felisan99/Breeze-UY/img/poster_breeze.jpg

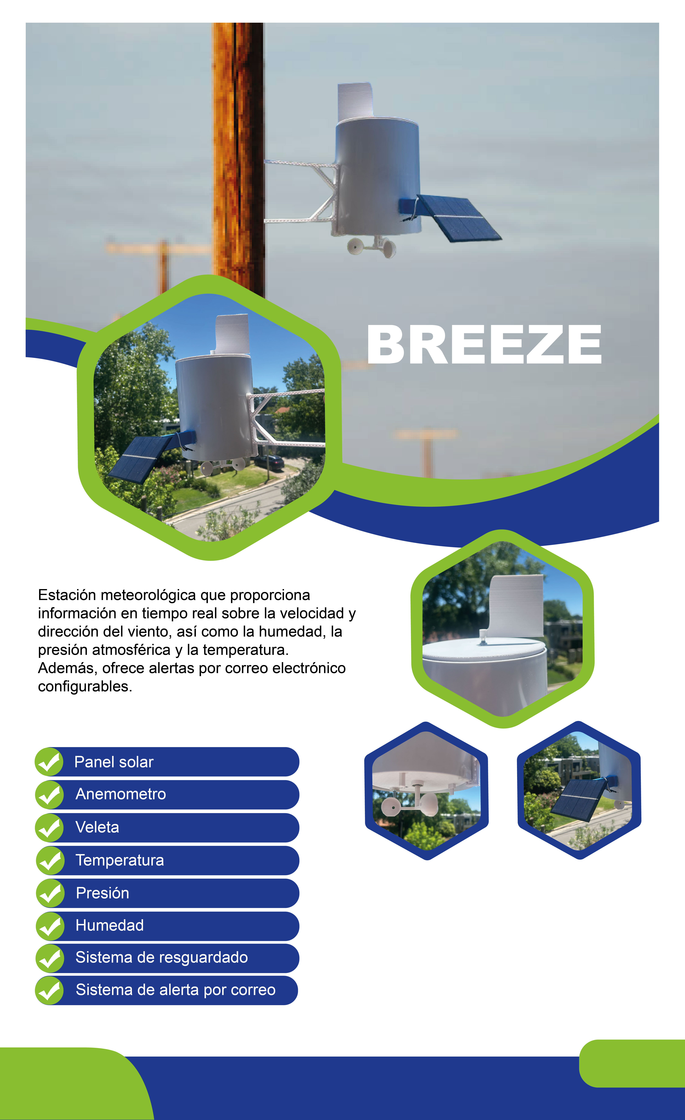
img/poster_breeze.jpg
