felisan99/Breeze-UY/img/joaco.png

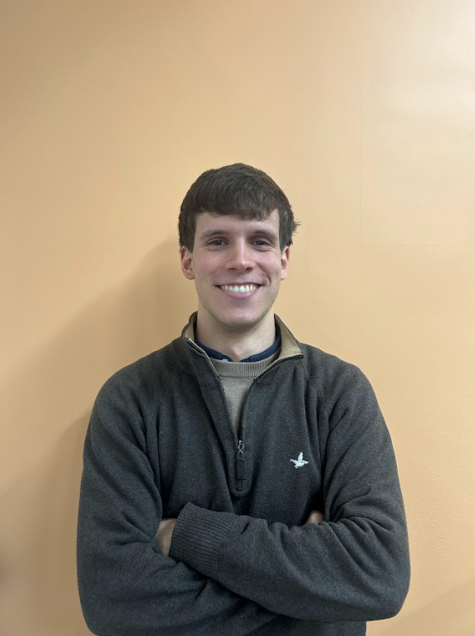
img/joaco.png
