felisan99/Breeze-UY/img/cargador.jpeg

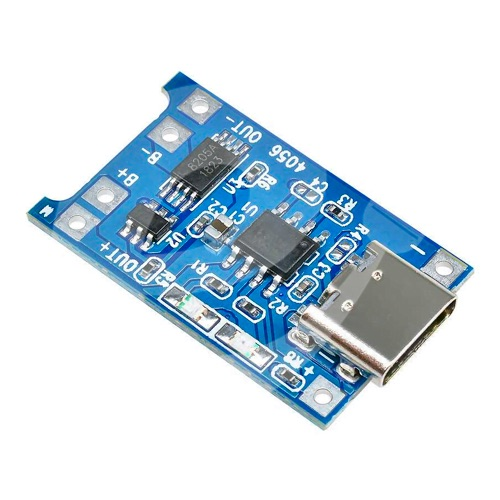
img/cargador.jpeg
