felisan99/Breeze-UY/img/Diagrama modulos.png

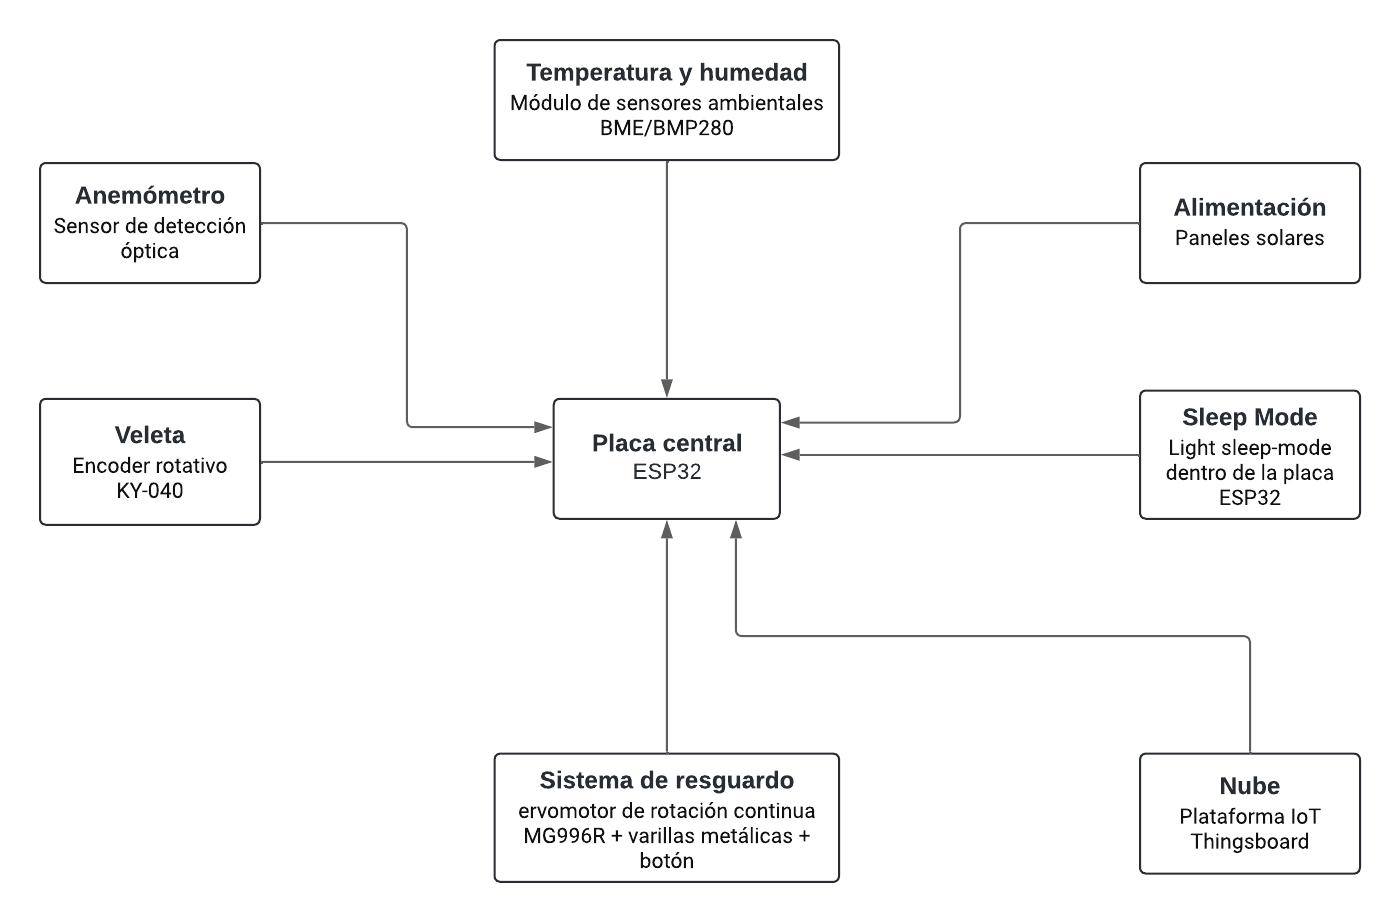
img/Diagrama modulos.png
