felisan99/Breeze-UY/img/elias.png

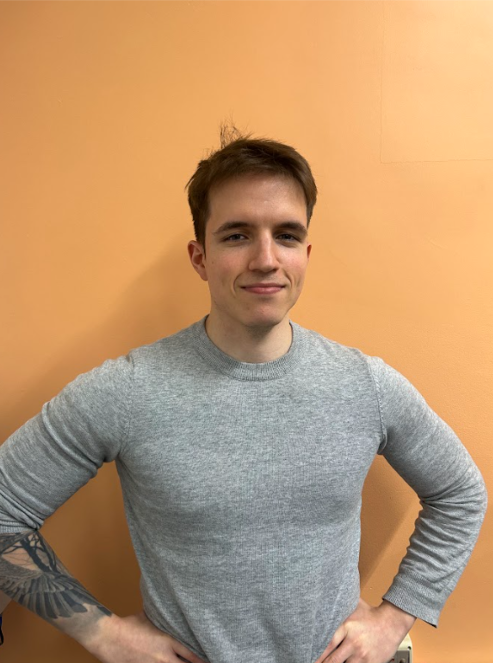
img/elias.png
