felisan99/Breeze-UY/img/elsid.png

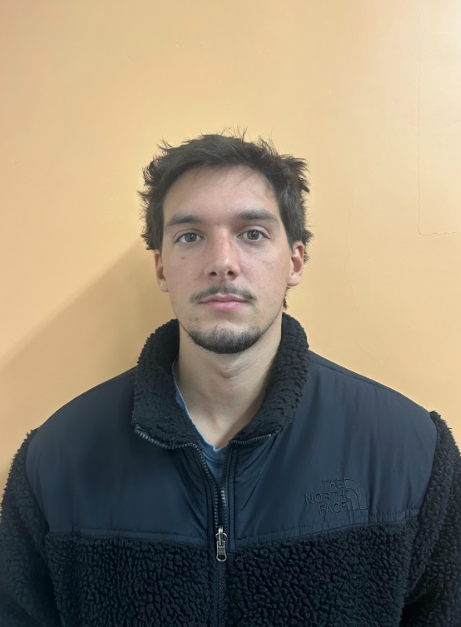
img/elsid.png
