felisan99/Breeze-UY/img/encoder.jpeg

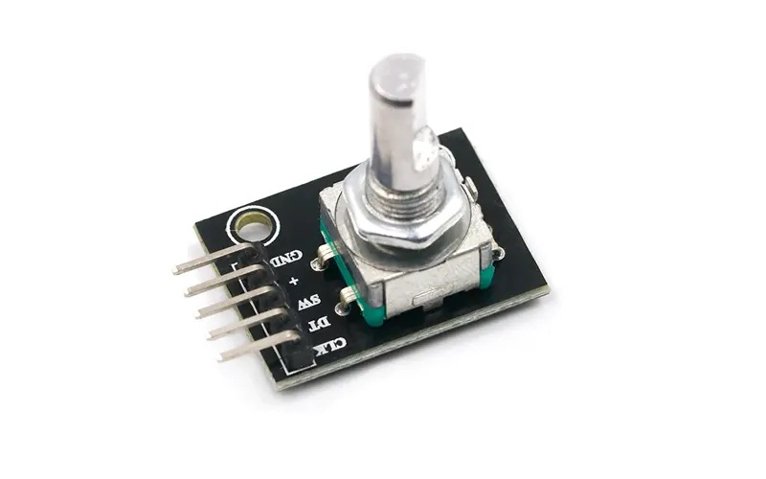
img/encoder.jpeg
