felisan99/Breeze-UY/img/flujo_loop.png

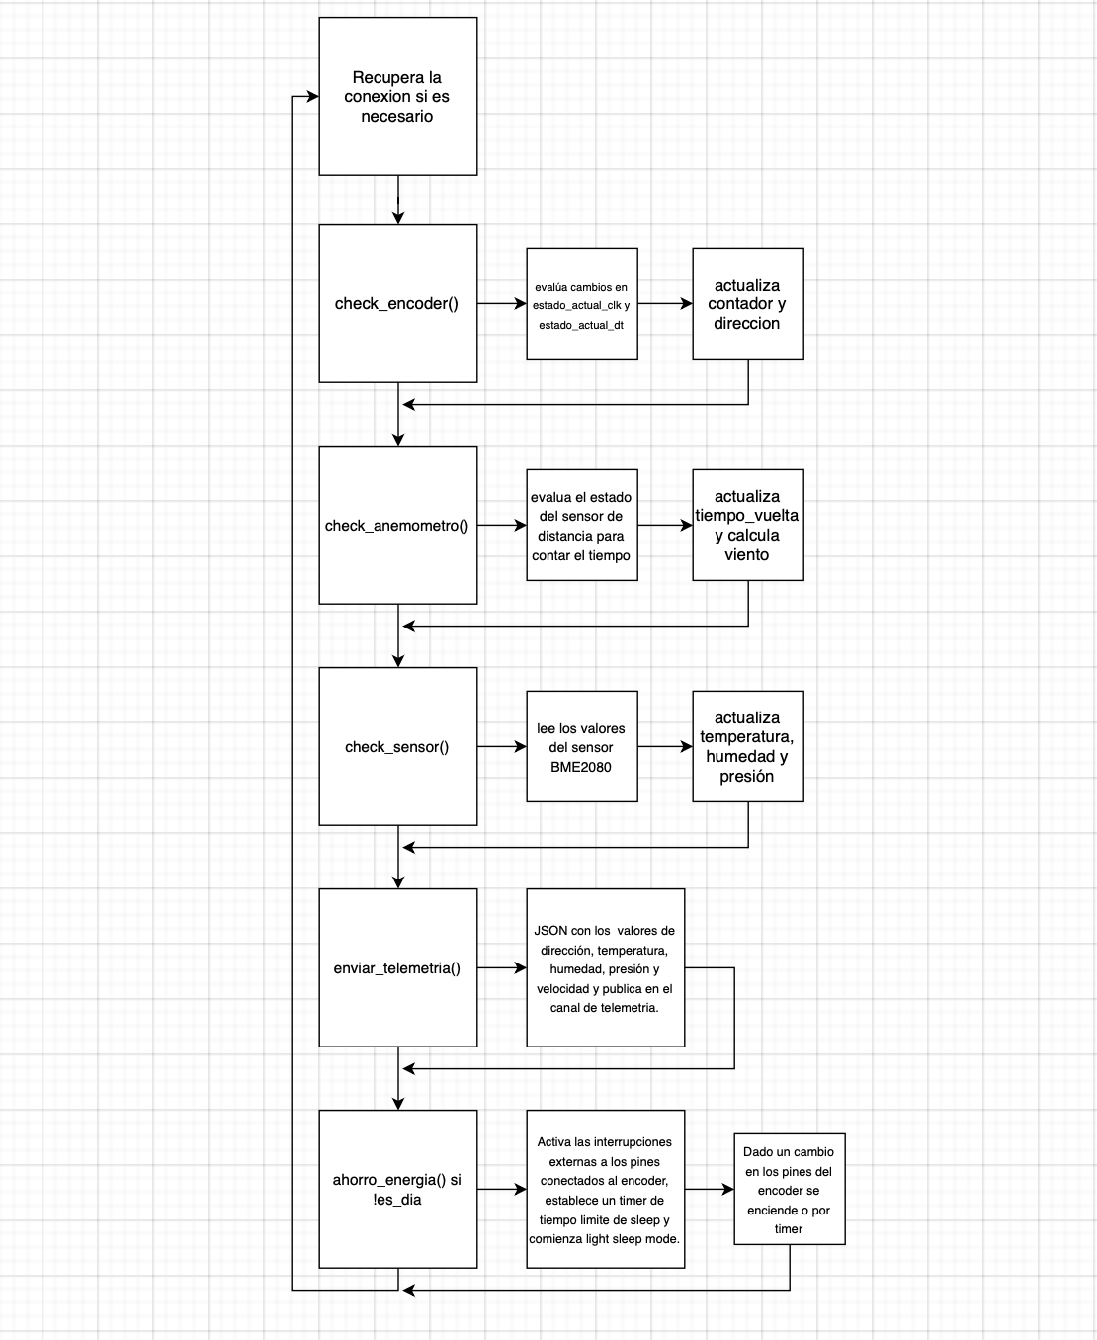
img/flujo_loop.png
