felisan99/Breeze-UY/img/foto breeze 1.jpeg

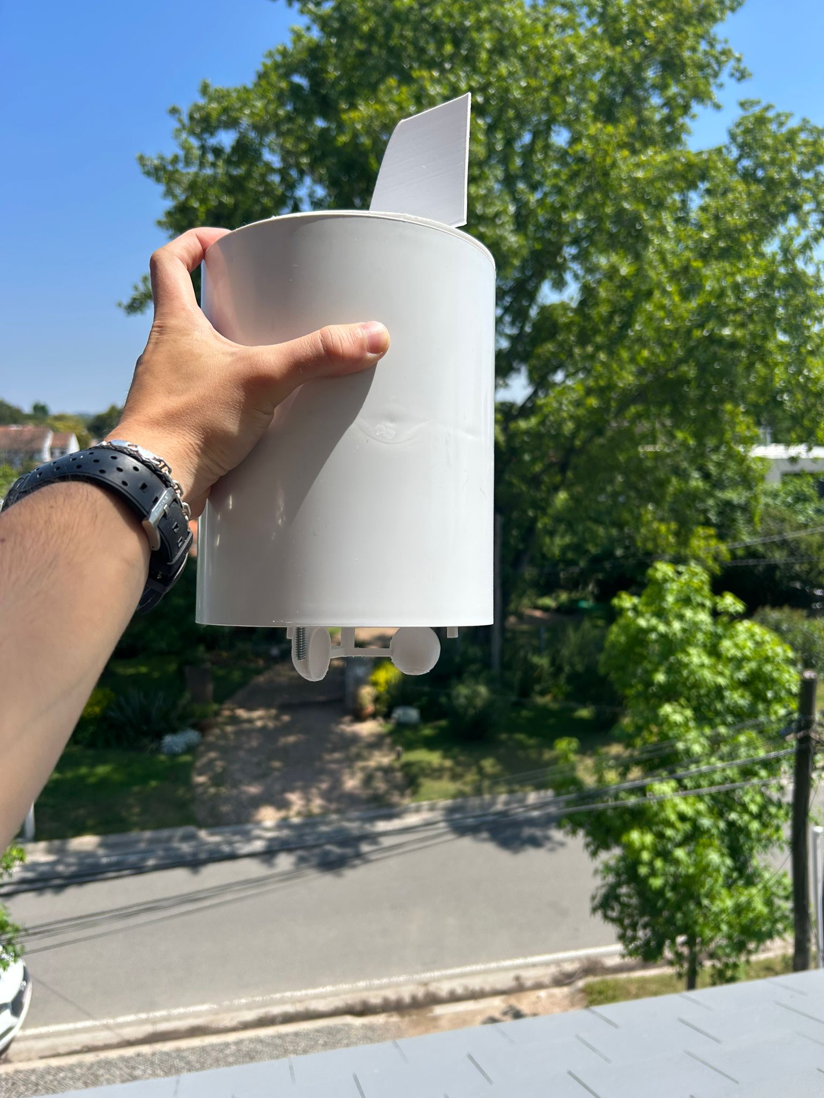
img/foto breeze 1.jpeg
