felisan99/Breeze-UY/img/foto breeze 2.jpeg

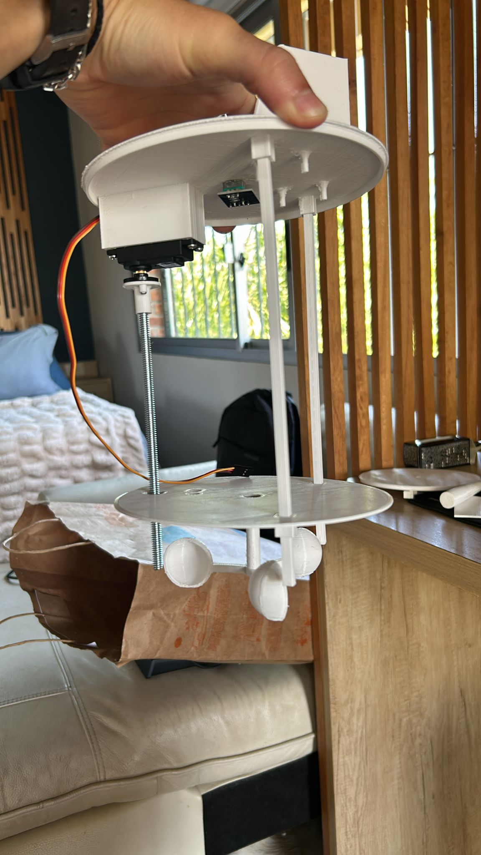
img/foto breeze 2.jpeg
