felisan99/Breeze-UY/img/foto breeze 3.jpeg

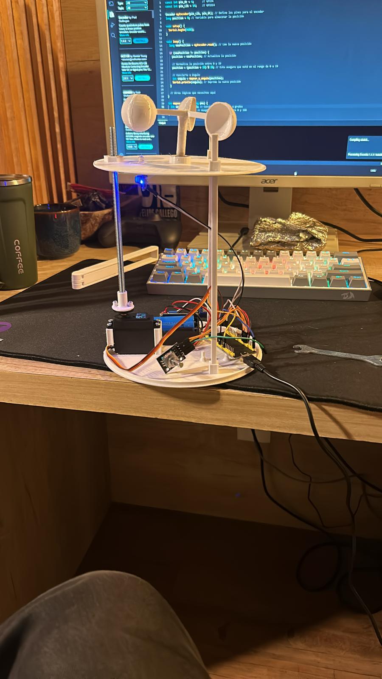
img/foto breeze 3.jpeg
