felisan99/Breeze-UY/img/gantt_anteproyecto.png

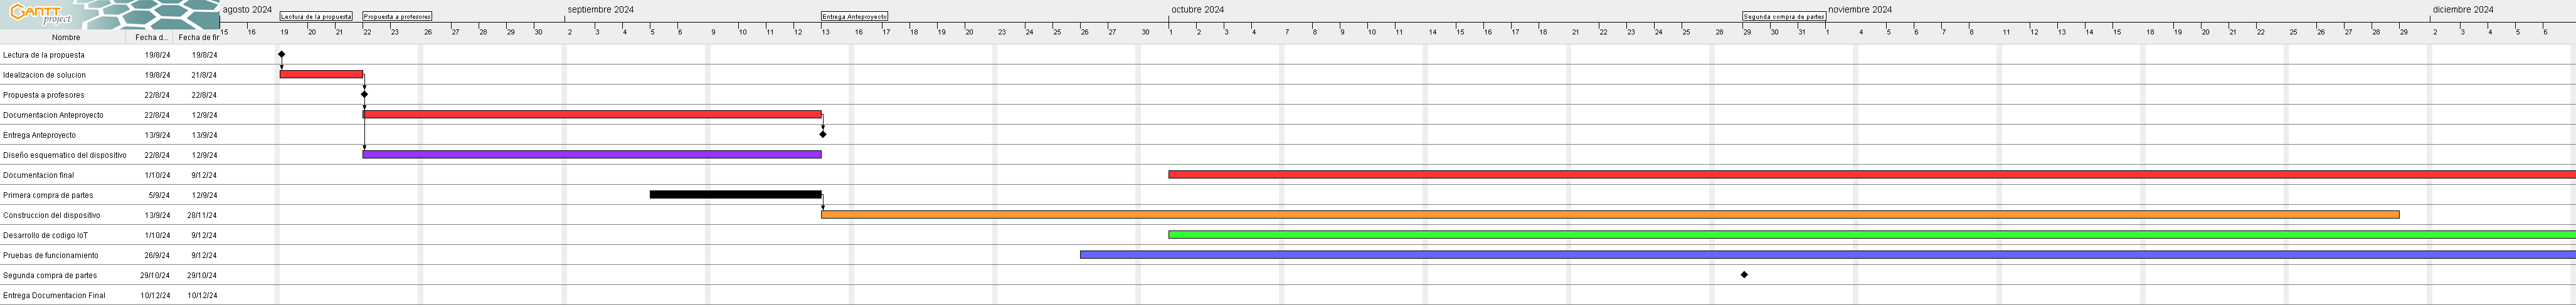
img/gantt_anteproyecto.png
