felisan99/Breeze-UY/img/gantt_final.png

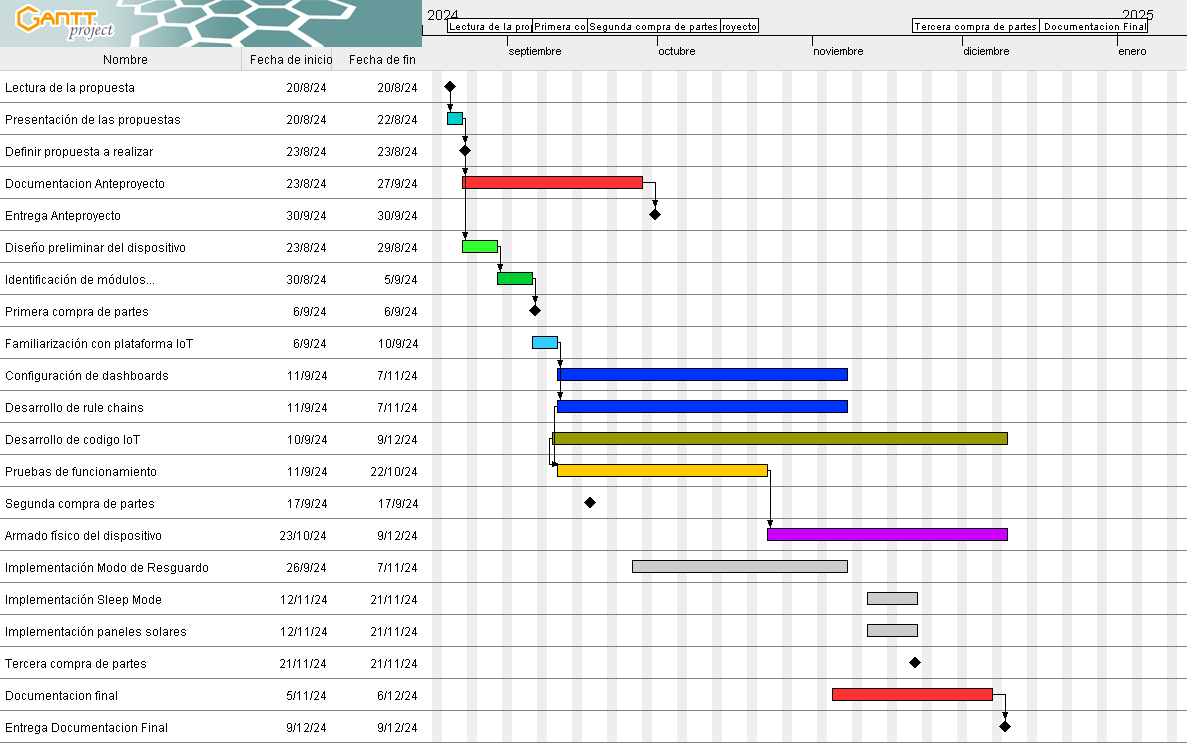
img/gantt_final.png
