felisan99/Breeze-UY/img/imagen-alerta-salgoderesguardo.png

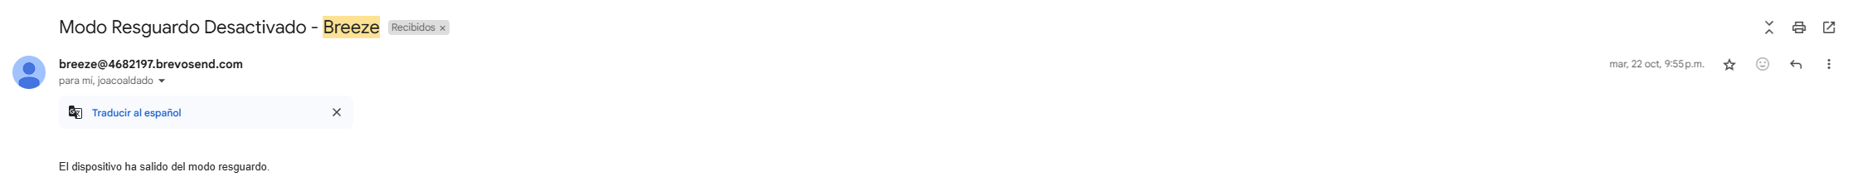
img/imagen-alerta-salgoderesguardo.png
