felisan99/Breeze-UY/img/imagen-alerta-voyaresguardo.png

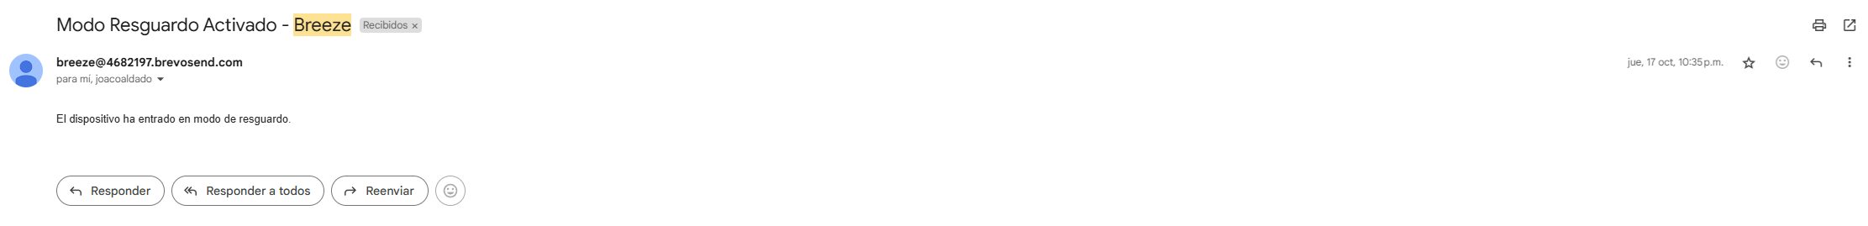
img/imagen-alerta-voyaresguardo.png
