felisan99/Breeze-UY/img/imagen-cadena-alarmas.png

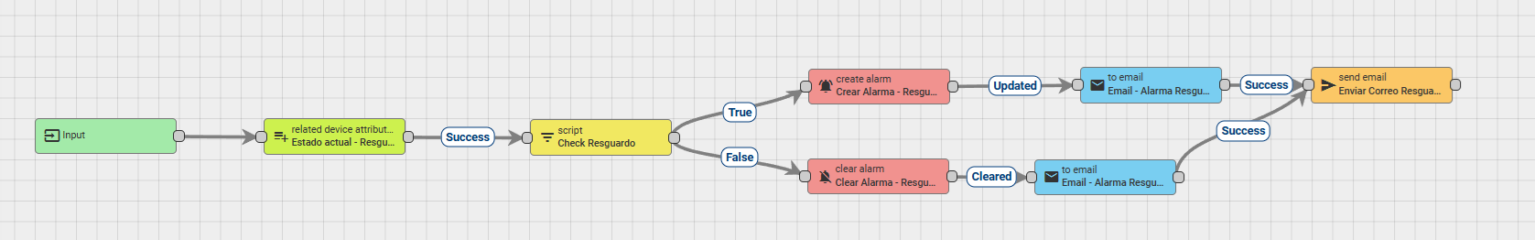
img/imagen-cadena-alarmas.png
