felisan99/Breeze-UY/img/imagen-cadena-logicabreeze.png

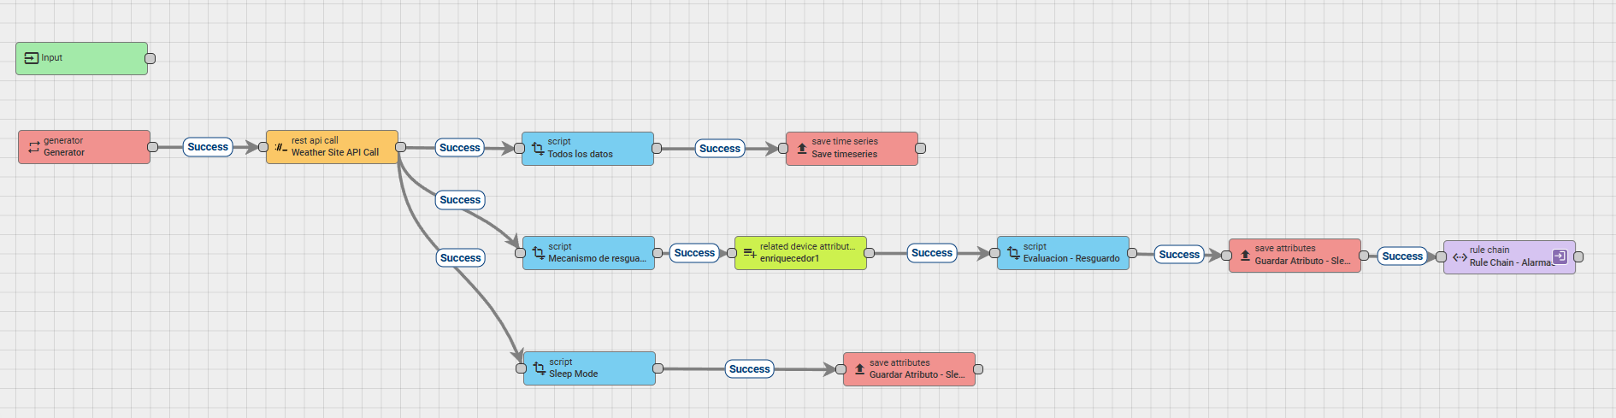
img/imagen-cadena-logicabreeze.png
