felisan99/Breeze-UY/img/interacciones.png

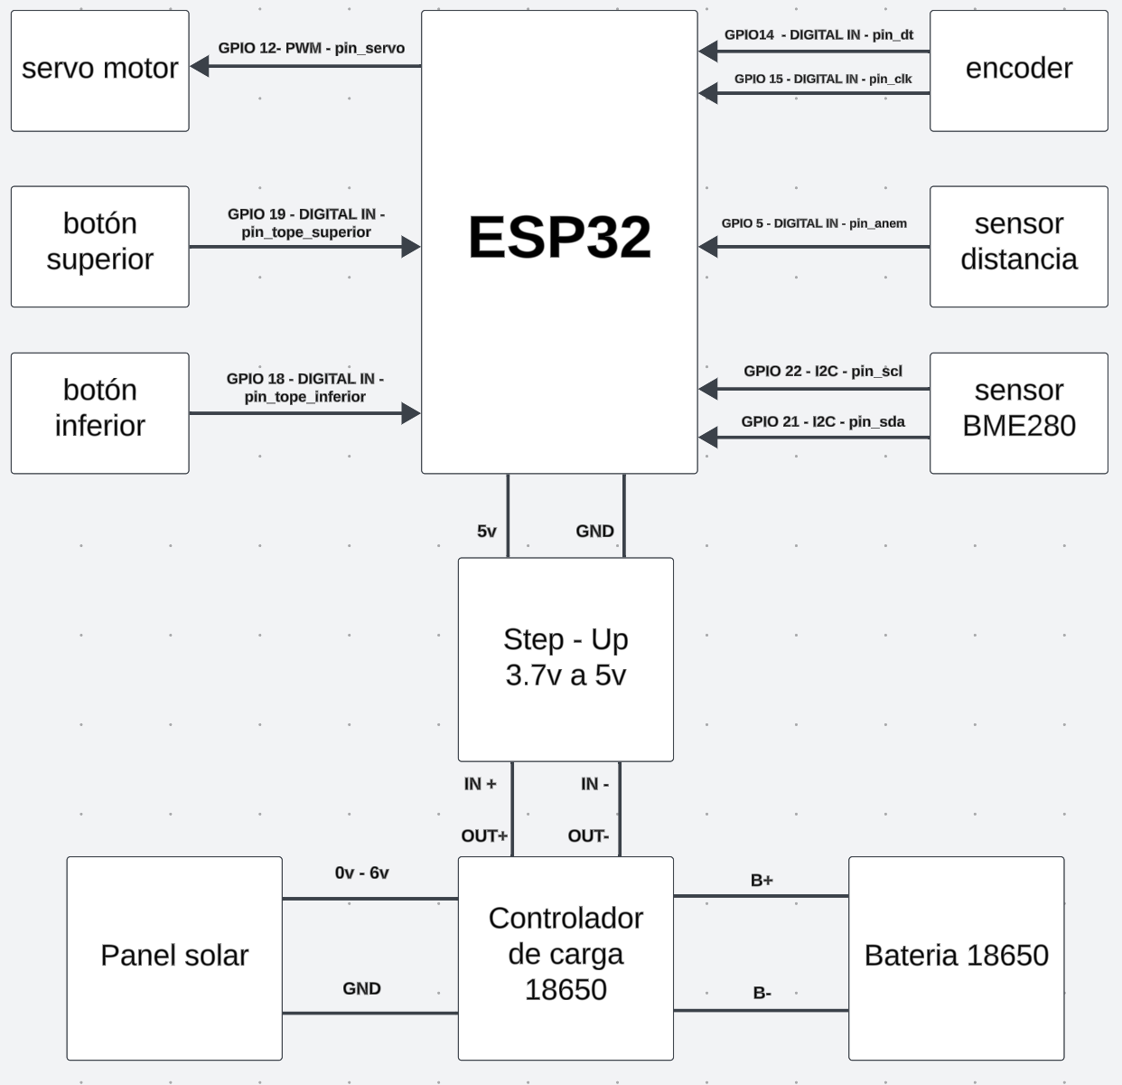
img/interacciones.png
