felisan99/Breeze-UY/img/paletas.png

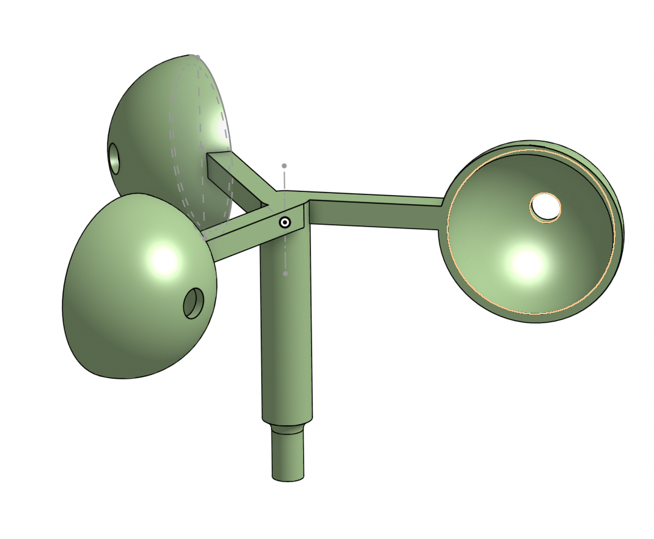
img/paletas.png
