felisan99/Breeze-UY/img/panel.jpeg

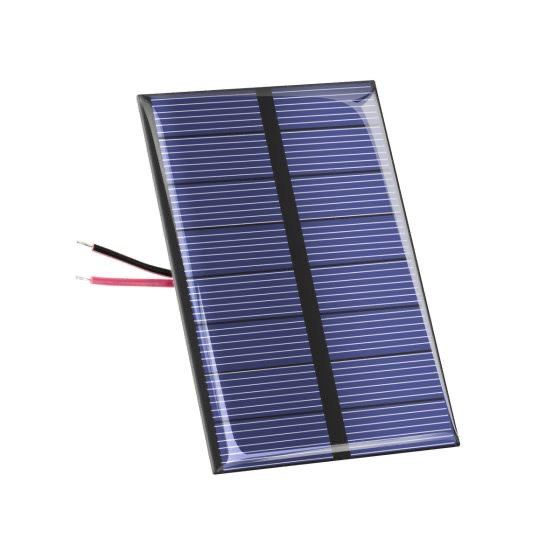
img/panel.jpeg
