felisan99/Breeze-UY/img/sensor.jpeg

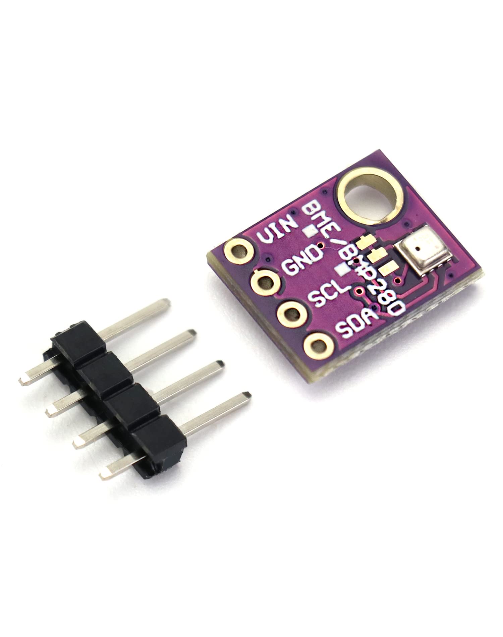
img/sensor.jpeg
