felisan99/Breeze-UY/img/sensor_distancia.jpeg

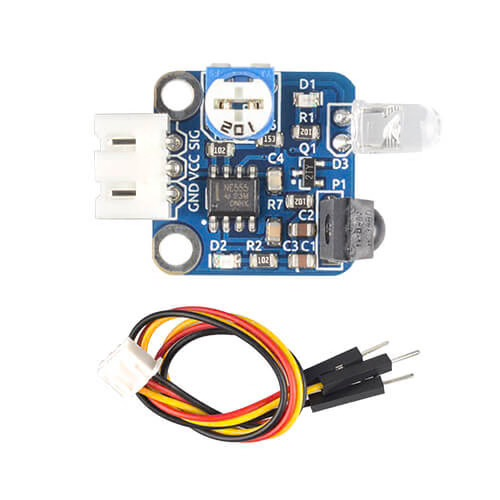
img/sensor_distancia.jpeg
