felisan99/Breeze-UY/img/servo.jpeg

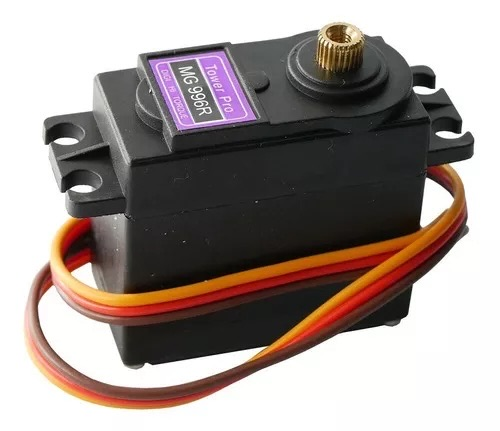
img/servo.jpeg
