felisan99/Breeze-UY/img/stepup.jpeg

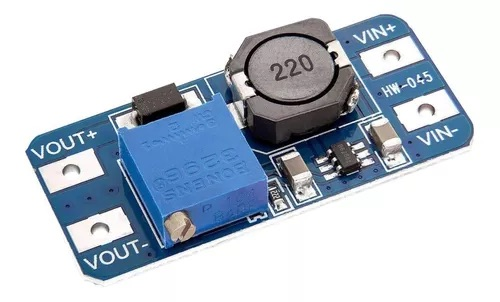
img/stepup.jpeg
