felisan99/Breeze-UY/img/veleta.png

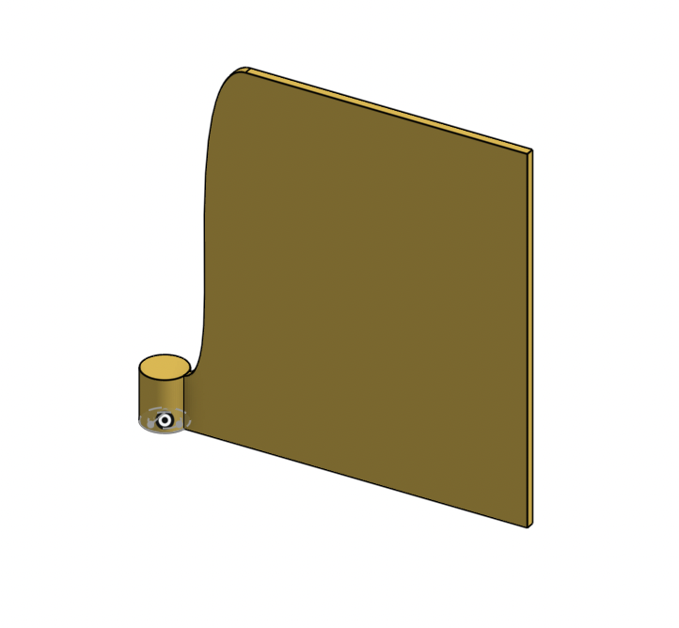
img/veleta.png
